samkohn/larpix-powerboard/(threads)

Thread 1 (2018-03-03):

Larger drill holes for FPGA

samkohn, 2018-03-03:
The via/hole size for the FPGA pins are too small

Closed 2018-03-06.

Thread 2 (2018-03-03):

Provide appropriate voltage to level translator

samkohn, 2018-03-03:
Level translator VCCA (FPGA side) should have an adjustable voltage (supplied by PowerBoost board), likely using a linear translator/voltage regulator

Thread 4 (2018-03-05):

Provide 5V to voltage regulators

samkohn, 2018-03-05:
Currently the voltage regulators get the raw battery voltage. They should instead receive 5V from the PowerBoost

Thread 5 (2018-03-05):

Add extra through-hole solder pads

samkohn, 2018-03-05:
Add extra solder pads in case we need to make tweaks by adding on new components. Suggested pads include:

- 5V from PowerBoost
- some IO pins from the FPGA
- GND
- a collection of "breadboard style" holes connected in groups of 3 or 5

Thread 8 (2018-03-30):

Align raspberry Pi pins

samkohn, 2018-03-30:
Traces on board are off by 1 location

samkohn, 2018-03-30:
And also GND is in the wrong location
