samkohn/larpix-powerboard/(commit log)

2017-12-21 Power board basics
    [schematic.kicad_pcb, schematic.sch]
2017-12-21 Add LT3080 linear regulator component to library
2017-12-21 Add voltage regulators to schematic
    [schematic.sch]
2017-12-21 Finish schematic for current board
    [schematic.sch]
2017-12-25 Add final resistors and POTs; begin associating footprints
    [schematic.sch]
2017-12-25 Update the FPGA schematic symbol to include all the pins
    [schematic.sch]
2017-12-25 Add netlist file and custom footprints
2017-12-25 Remove schematic-rescue (backup) from library list
2017-12-25 Add netlist and PCB file
    [schematic.sch]
2017-12-25 Rearrange some components and begin laying traces
    [schematic.kicad_pcb]
2017-12-25 Finish connecting all components, GND plane, & traces
    [schematic.kicad_pcb]
2017-12-27 Adjust to Dan's comments
    - add second 2x1 header pins at battery output
    - connect linear regulators for VCM and VREF directly to VCC_A (battery)
    rather than to output of VDDA regulator
    - Move VDDA regulator to a more convenient and compact location on the
    board
    [schematic.kicad_pcb, schematic.sch]
2017-12-27 Add new level translator to schematic library
2017-12-27 Add level translator to schematic
    [schematic.sch]
2017-12-27 Add level translator to PCB layout
    [schematic.kicad_pcb]
2017-12-27 Update track routing
    [schematic.kicad_pcb]
2017-12-27 Add 3-pin header for BAT/EXT
    [schematic.kicad_pcb, schematic.sch]
2017-12-28 Redo layout of PCB with (mostly) larger traces
    [schematic.kicad_pcb, schematic.sch]
2017-12-28 Add fuse holder to schematic and pcb layout
    [schematic.kicad_pcb, schematic.sch]
2017-12-28 Re-layout and reroute analog power & rows of headers
    [schematic.kicad_pcb]
2017-12-29 Replace batteries with PowerBoost; add RPi
    [schematic.sch]
2017-12-29 Add RPi and USB power supply to PCB layout
    [schematic.kicad_pcb]
2017-12-29 Add silkscreen labels
    [schematic.kicad_pcb]
2018-01-02 Add ground plane on back layer
    [schematic.kicad_pcb]
2018-01-02 Update schematic per Thorsten's suggestions
    - Power RPi from a trace on the board
    - Add bypass capacitors to the power inputs on FPGA and RPi
    - Add a third bypass capacitor to the voltage regulator inputs
    - Tie unused third pin on POTs to the signal pin
    - Add 2 bypass capacitors to the level translator pin 15
    [schematic.sch]
2018-01-02 Replace POT/Level Translator headers with solder bridges
    [schematic.sch]
2018-01-02 Update Potentiometer footprint file
2018-01-02 Update the footprint assignments in the schematic
    New capacitors
    Solder bridges = resistors
    [schematic.sch]
2018-01-02 Update schematic netlist
2018-01-03 Address most of Thorsten's comments in the PCB layout
    [schematic.kicad_pcb]
2018-01-03 Improve silkscreen labels
    [schematic.kicad_pcb]
2018-01-03 Update dimensions of FPGA footprint
2018-01-03 Update FPGA location and also add many labels
    [schematic.kicad_pcb]
2018-01-03 Fix weird zone outline thing
    [schematic.kicad_pcb]
2018-01-03 Add mounting holes
    [schematic.kicad_pcb]
2018-01-03 Move capacitor labels; add labels for FPGA, RPi, and USB charger
    [schematic.kicad_pcb]
2018-01-03 Prep for submission
    - add back layer soldermask, silkscreen, etc.
    - add silkscreen mark showing outline of 50-pin header connector
    - add labels for RPi, FPGA, and PowerBoost
    [schematic.kicad_pcb]
2018-01-03 Finish prepping board for production
    - Add byline & version info
    - Increase via size so pad size = drill size + 0.018"
    - Add README for Gerber files
    [schematic.kicad_pcb]
2018-01-03 Ignore gerbers directory
2018-03-06 Increase size of drill holes for FPGA (Fixes #1)
